dfalsafi/Electrocardiogram_ECG_Medical_Device_Design/Documentation/Final Report Format.pdf

# EKG Design Project

### TA: Navametha Ramkumar

### Team Members : Danyal Falsafi, Danny Kaddoura

### Henry Stenzel, Samuel Zilmer

03/20/2026

Design/Solution

Overview

Description of the design, including a discussion of key components/purpose. One figure showing the schematic is sufficient:

- LT SPICE simulation
- PCB Altium Trace and Schematic Sketches
- Chips used were the OPA333(feedback amplifier to the right leg and also an adjusted gain amplifier) and INA333(instrumental amplifier to get rid of the common mode signal)

Describe any modifications to the project the deviated from the Design

Proposal:

- Adding a Notch Filter
- Setting a DC offset to clean up noise read by the ADC when analyzing the signal processed by the PIC24 using PyPlotter in real-time.

Conclusion/Summary

Describe in detail how the project did or did not meet the specifications listed in the Project Description. If your group experienced any difficulties in the design and fabrication process please describe them in detail.
