dfalsafi/Electrocardiogram_ECG_Medical_Device_Design/Hardware/Analog Design & LTSPICE Simulation/EKG_Danny-20260504T213633Z-3-001/Circuit_Design.png

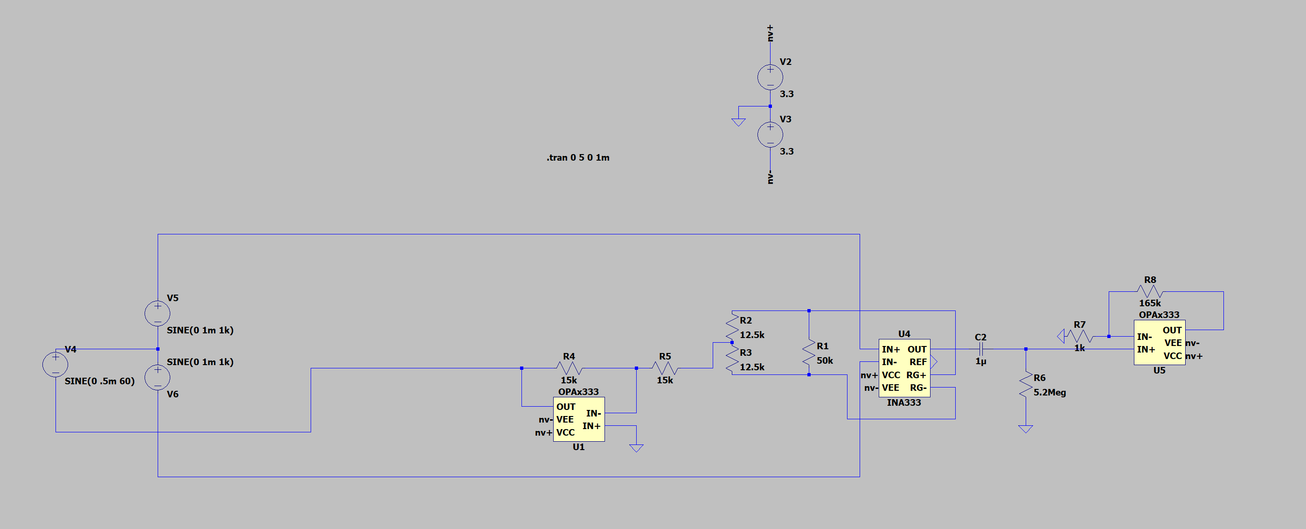
Hardware/Analog Design & LTSPICE Simulation/EKG_Danny-20260504T213633Z-3-001/Circuit_Design.png
