dfalsafi/Electrocardiogram_ECG_Medical_Device_Design/Hardware/Analog Design & LTSPICE Simulation/possible final component swaps.pdf

Dont used blacked it is alternate options.
Maybe get 5x needed? Just in case.
- 4x 5% tol 1u caps (higher tolerance for notch filter; non polar)
- 5mm lead spacing
https://www.digikey.com/en/products/detail/kemet/R82EC4100DQ70J/1930809
- 5mm spacing
https://www.digikey.com/en/products/detail/tdk/B32529C0105J000/592697
- 1x 100uf Non-polar caps (to avoid potential failure of AC on polar cap)
- https://www.digikey.com/en/products/detail/tdk/FG11X5R0J107MRT06/5802726
- https://www.digikey.com/en/products/detail/tdk/FK22X5R0J107MN000/1008928
- 5x 1.3k resistors (better tolerance & avoid series comb)
- https://www.digikey.com/en/products/detail/stackpole-electronics-inc/RNMF14FTC1K30/2617304 (https://www.digikey.com/en/products/detail/stackpole-electronics-inc/RNMF14FTC1K30/2617304)
- https://www.digikey.com/en/products/detail/yageo/MFR50SFTE52-1K3/9151169
- 1x 62k res (replace 57k+5.7k)
- https://www.digikey.com/en/products/detail/stackpole-electronics-inc/CF18JT62K0/1741754 (https://www.digikey.com/en/products/detail/stackpole-electronics-inc/CF18JT62K0/1741754)
- 2x 11k ohm (replace 10+1)
- https://www.digikey.com/en/products/detail/yageo/MFR-25FRF52-11K/14988
- 2x 200k (replace 100k+100k)
- https://www.digikey.com/en/products/detail/stackpole-electronics-inc/CF14JT200K/1741338 (https://www.digikey.com/en/products/detail/stackpole-electronics-inc/CF14JT200K/1741338)
- https://www.digikey.com/en/products/detail/stackpole-electronics-inc/RNF14FTD200K/1706702 (https://www.digikey.com/en/products/detail/stackpole-electronics-inc/RNF14FTD200K/1706702)
- 20 opa33s
- 20ina333s
