dfalsafi/Electrocardiogram_ECG_Medical_Device_Design/Hardware/Analog Design & LTSPICE Simulation/EKG_v2_withOffset.asc

C2: cap; 100µ
R1: res; 100k
R2: res; 100k
R3: res; 10k
R4: res; 15k
R5: res; 15k
R6: res; 57k
R7: res; 1k
R8: res; 100k
R9: res; 100k
R10: res; 100k
R11: res; 100k
R12: res; 100k
R13: res; 100k
R14: res; 10k
R15: res; 1k
R16: res; 1k
R17: res; 1.5k
R18: res; 1.5k
R19: res; 5.7k
R20: res; 100k
R21: res; 100k
U1: OPAx333
U2: OPAx333
U4: INA333
U5: OPAx333
V2: voltage; 3
V3: voltage; 3
V4: voltage; SINE(0 .5m 100); AC 1m
V5: voltage; SINE(0 1m 1); AC 1m
V6: voltage; SINE(0 1m 1); AC 1m
Named nets: 0, nv-, nv+, nOUT, nvin+, nvin-, nRLD
.tran 0 5 0 1m
.ac dec 40 .5 10
