dfalsafi/Electrocardiogram_ECG_Medical_Device_Design/Hardware/Analog Design & LTSPICE Simulation/EKG_v4_withNotch&reducedResistors.asc

C1: cap; 1µ
C2: cap; 100µ
C3: cap; 1µ
C4: cap; 1µ
C5: cap; 1µ
R1: res; 100k
R2: res; 100k
R4: res; 15k
R5: res; 15k
R6: res; 62k
R7: res; 1k
R8: res; 100k
R9: res; 100k
R10: res; 200k
R11: res; 100k
R12: res; 100k
R13: res; 200k
R15: res; 11k
R16: res; 11k
R17: res; 1.5k
R18: res; 1.5k
R22: res; 1.3k
R23: res; 1.3k
R26: res; 1.3k
R27: res; 1.3k
R31: res; 1.3k
U1: OPAx333
U2: OPAx333
U4: INA333
U5: OPAx333
V2: voltage; 3
V3: voltage; 3
V4: voltage; SINE(0 .5m 100); AC 1m
V5: voltage; SINE(0 1m 1); AC 1m
V6: voltage; SINE(0 1m 1); AC 1m
Named nets: 0, nv-, nv+, nOUT, nvin+, nvin-, nRLD
.tran 0 5 0 1m
.ac dec 40 .5 10
