dfalsafi/Electrocardiogram_ECG_Medical_Device_Design/Hardware/Analog Design & LTSPICE Simulation/EKG_Danny-20260504T213633Z-3-001/EKG.asc

C2: cap; 1µ
R1: res; 50k
R2: res; 12.5k
R3: res; 12.5k
R4: res; 15k
R5: res; 15k
R6: res; 5.2Meg
R7: res; 1k
R8: res; 165k
U1: OPAx333
U4: INA333
U5: OPAx333
V2: voltage; 3.3
V3: voltage; 3.3
V4: voltage; SINE(0 .5m 1meg)
V5: voltage; SINE(0 1m 1k)
V6: voltage; SINE(0 1m 1k)
Named nets: 0, nv-, nv+
.tran 0 5 0 1m
